zeha/wiener-netze-smartmeter-slop/site/og-image.png

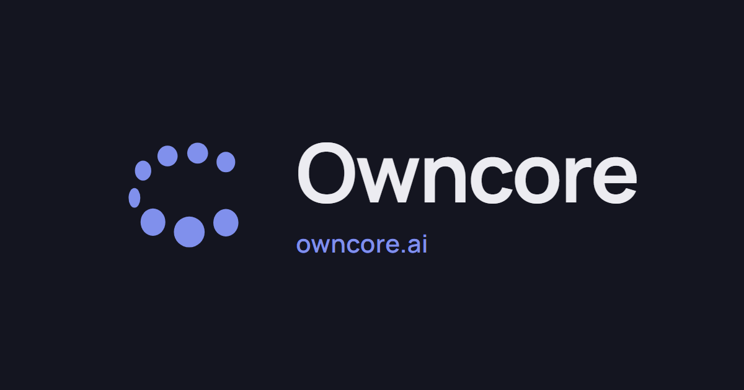
site/og-image.png
