zeha/wiener-netze-smartmeter-slop/hardware/power-dock/BOM.csv

Reference | Qty | Value | Package | LCSC | MPN | Manufacturer
U1 | 1 | TP4056 | ESOP-8 (SOIC-8 3.9x4.9 P1.27) | C725790 | TP4056 | UMW (Youtai)
U2 | 1 | AO3401 | SOT-23 (1=G 2=S 3=D) | C727156 | AO3401 | TWGMC
J1 | 1 | USB-C 16 pin | SMD USB-C (JLC footprint) | C393939 | TYPE-C16PIN | SHOU HAN
J2 | 1 | JST-PH 2P | JST-PH 2.0 mm, right-angle | C157932 | S2B-PH-K-S-GW | JST
J3 | 1 | JST-PH 2P (optional 2nd battery) | JST-PH 2.0 mm, right-angle | C157932 | S2B-PH-K-S-GW | JST
F1 | 1 | PTC 1A | 0805 | C22472456 | SMD0805-100C-6V | BNstar
F2 | 1 | PTC 1A (optional 2nd battery) | 0805 | C22472456 | SMD0805-100C-6V | BNstar
R1 | 1 | 5.1k | 0603 | C14677 | RC0603JR-075K1L | YAGEO
R7 | 1 | 5.1k | 0603 | C14677 | RC0603JR-075K1L | YAGEO
R2 | 1 | 2.4k | 0603 | C127450 | RC0603JR-072K4L | YAGEO
R3 | 1 | 1k | 0603 | C14676 | RC0603JR-071KL | YAGEO
R4 | 1 | 10k | 0603 | C99198 | RC0603JR-0710KL | YAGEO
R5 | 1 | 1M | 0603 | C107698 | RC0603JR-071ML | YAGEO
R6 | 1 | 1M | 0603 | C107698 | RC0603JR-071ML | YAGEO
C1 | 1 | 10uF 16V | 0603 | C108340 | 0603X106M160NT | FH
C2 | 1 | 10uF 16V | 0603 | C108340 | 0603X106M160NT | FH
D1 | 1 | red LED | 0603 | C19171390 | YLED0603R | YONGYUTAI
P1 | 1 | 1x6 header | 1x6 2.54 mm THT | C5156615 | 2.54-1*6 | ZHOURI
P2 | 1 | 1x4 header | 1x4 2.54 mm THT | C5116483 | 2.54-1*4 | ZHOURI
