zeha/wiener-netze-smartmeter-slop/hardware/power-dock/out/power-dock-schematic.pdf

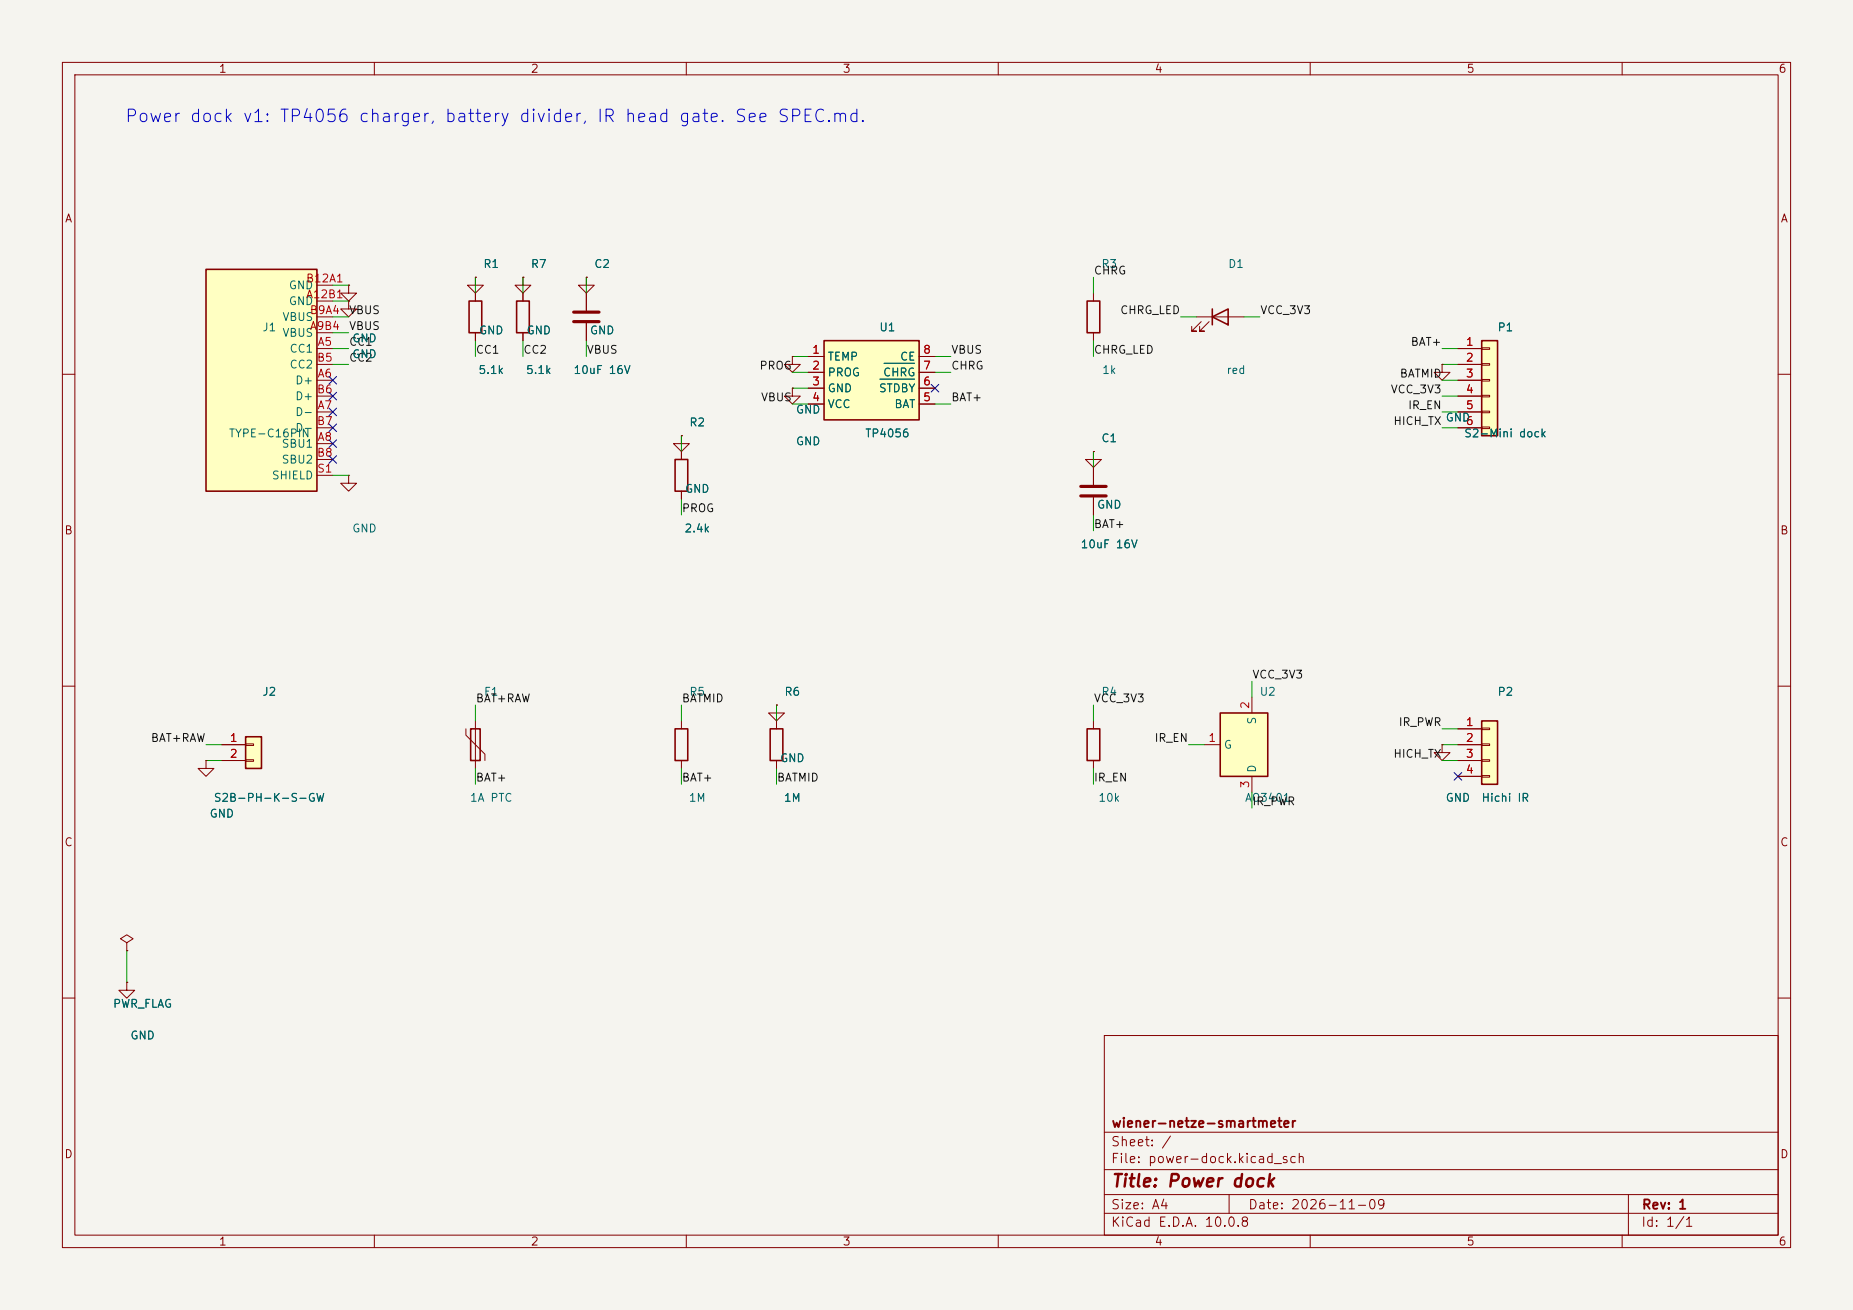
[picture p2: page 1]

Size: A4 | Rev: 1
KiCad E.D.A. 10.0.8 | Id: 1/1
