zeha/wiener-netze-smartmeter-slop/hardware/power-dock/out/power-dock-board.pdf

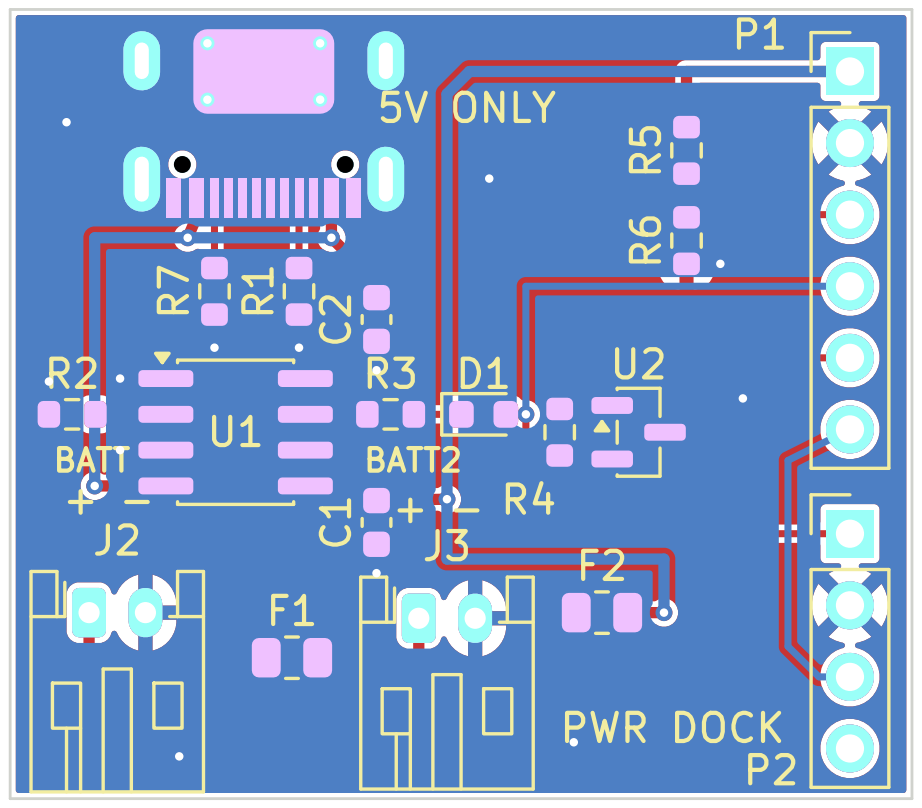
[picture p3: page 1]
