zeha/wiener-netze-smartmeter-slop/hardware/power-dock/power-dock.kicad_pcb

## KiCad design hardware/power-dock/power-dock.kicad_pcb (2026-11-11)

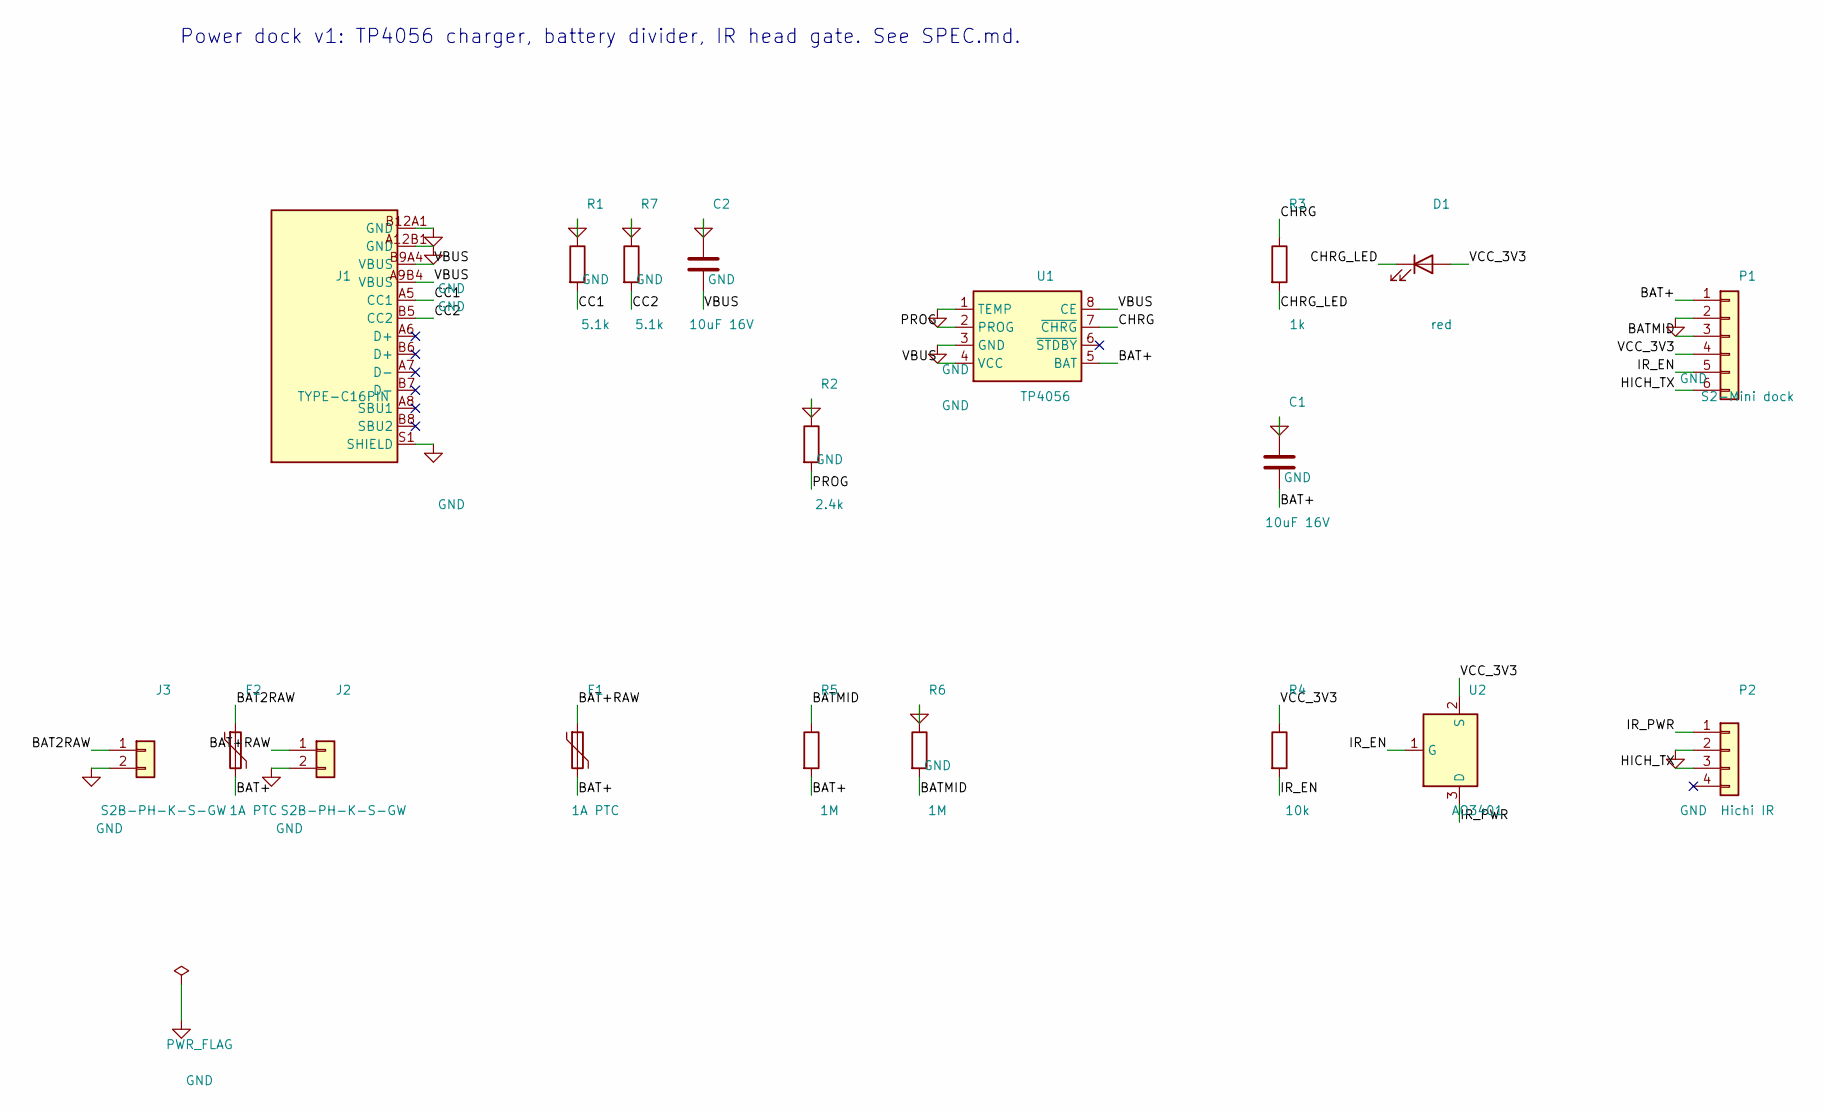
[picture p4: schematic power-dock.kicad_sch, Power dock]

Parts:
C1, C2: 10uF 16V; C_0603_1608Metric; MPN 0603X106M160NT; LCSC C108340
D1: red; LED_0603_1608Metric; MPN YLED0603R; LCSC C19171390
F1, F2: 1A PTC; R_0805_2012Metric; MPN SMD0805-100C-6V; LCSC C22472456
J1: TYPE-C16PIN; TYPE-C-SMD_HX-TYPE-C-16PIN; MPN TYPE-C16PIN; LCSC C393939
J2, J3: S2B-PH-K-S-GW; JST_PH_S2B-PH-K_1x02_P2.00mm_Horizontal; MPN S2B-PH-K-S-GW; LCSC C157932
P1: S2-Mini dock; PinHeader_1x06_P2.54mm_Vertical; MPN 2.54-1*6; LCSC C5156615
P2: Hichi IR; PinHeader_1x04_P2.54mm_Vertical; MPN 2.54-1*4; LCSC C5116483
R1, R7: 5.1k; R_0603_1608Metric; MPN RC0603JR-075K1L; LCSC C14677
R2: 2.4k; R_0603_1608Metric; MPN RC0603JR-072K4L; LCSC C127450
R3: 1k; R_0603_1608Metric; MPN RC0603JR-071KL; LCSC C14676
R4: 10k; R_0603_1608Metric; MPN RC0603JR-0710KL; LCSC C99198
R5, R6: 1M; R_0603_1608Metric; MPN RC0603JR-071ML; LCSC C107698
U1: TP4056; SOIC-8_3.9x4.9mm_P1.27mm; MPN TP4056; LCSC C725790
U2: AO3401; SOT-23; MPN AO3401; LCSC C727156

Connections:
/BAT2RAW: F2.1, J3.1
/BAT+: C1.2, F1.2, F2.2, P1.1, R5.2, U1.5 (BAT)
/BAT+RAW: F1.1, J2.1
/BATMID: P1.3, R5.1, R6.2
/CC1: J1.A5 (CC1), R1.2
/CC2: J1.B5 (CC2), R7.2
/CHRG: R3.1, U1.7 (~CHRG)
/CHRG_LED: D1.1 (K), R3.2
/HICH_TX: P1.6, P2.3
/IR_EN: P1.5, R4.2, U2.1 (G)
/IR_PWR: P2.1, U2.3 (D)
/PROG: R2.2, U1.2 (PROG)
/VBUS: C2.2, J1.A9B4 (VBUS), J1.B9A4 (VBUS), U1.4 (VCC), U1.8 (CE)
/VCC_3V3: D1.2 (A), P1.4, R4.1, U2.2 (S)
GND: C1.1, C2.1, J1.A12B1 (GND), J1.B12A1 (GND), J1.S1 (SHIELD), J2.2, J3.2, P1.2, P2.2, R1.1, R2.1, R6.1, R7.1, U1.1 (TEMP), U1.3 (GND)

Notes on the sheet:
Power dock v1: TP4056 charger, battery divider, IR head gate. See SPEC.md.

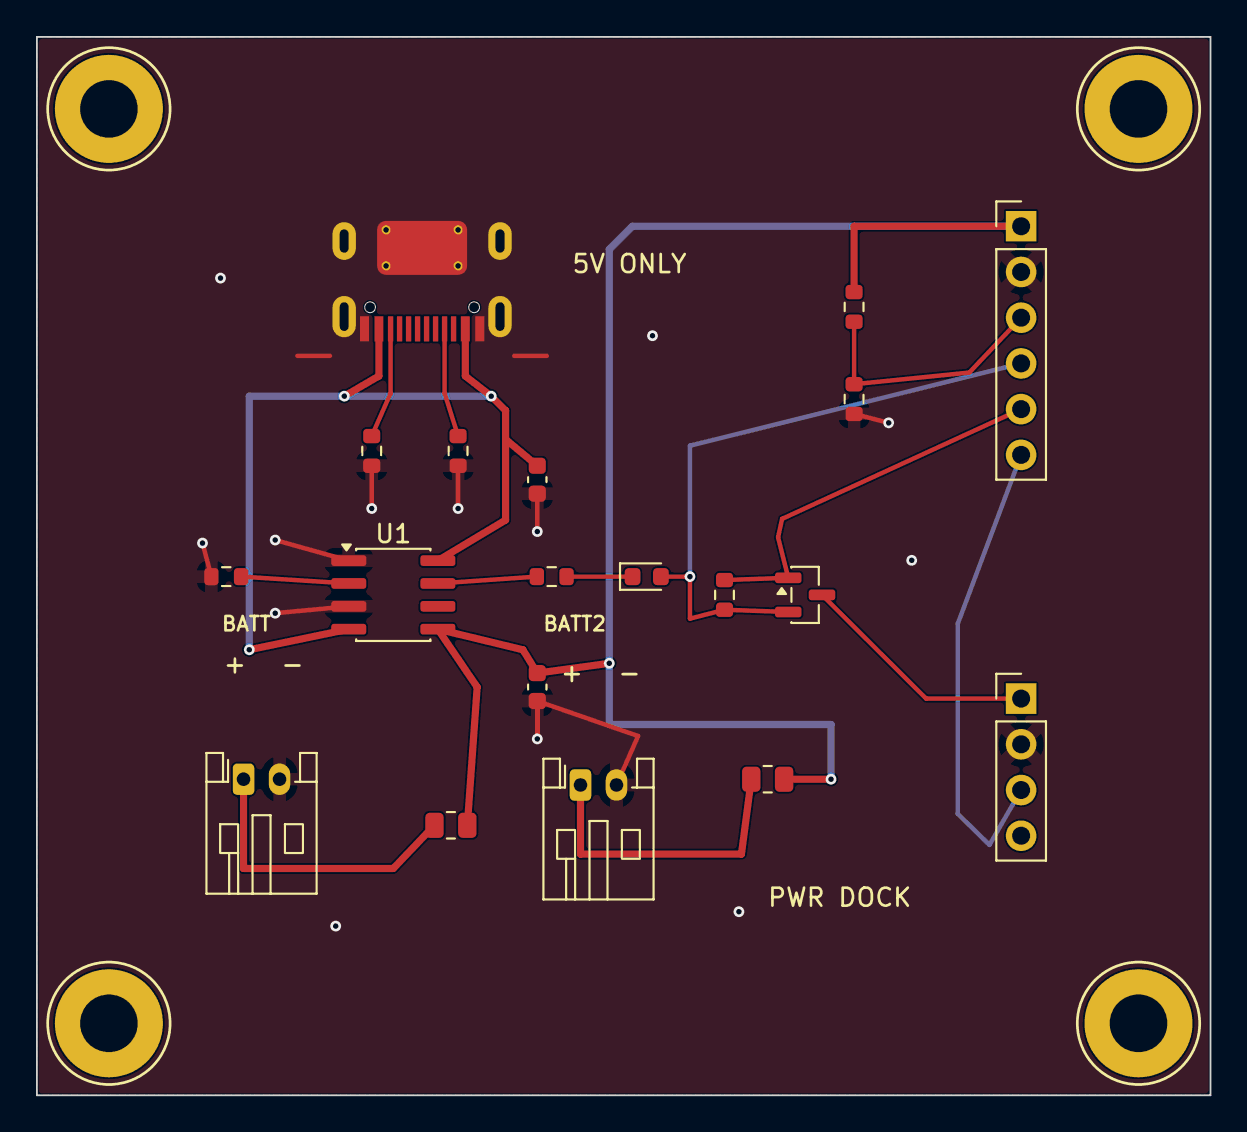
[picture p5: board power-dock.kicad_pcb from above]

Board: 2 copper layers, 65.2 x 58.8 mm, 23 parts (0 on the bottom side), 15 nets.

Other parts of the board:
MH1, MH2, MH3, MH4: 3.2mm; MountingHole_3.2mm_Pad
