zeha/wiener-netze-smartmeter-slop/(commit log)

2026-11-08 Add wiener_netze ESPHome component and example device config
2026-11-08 Drop deprecated UART settings check; the Python schema validates it
2026-11-08 Add battery voltage and level sensors to example config
2026-11-08 Fix battery wiring on overview page: LiPo to 5V/VBUS, not 3V3; note IR head idle current
2026-11-09 Add the required uart block to the install snippet on the overview page
    The snippet referenced uart_id meter_uart without defining the uart
    component, so ESPHome rejected it with 'Component wiener_netze requires
    component uart'. The snippet now includes the uart block (rx_pin GPIO21,
    9600 8N1) and says why it is mandatory; verified with esphome config.
2026-11-09 Fix the GitHub repo reference: it is wiener-netze-smartmeter-slop
    github.com/zeha/wiener-netze-smartmeter does not exist (404); the public
    repo is zeha/wiener-netze-smartmeter-slop, matching the git remote and the
    overview page. README snippet and the example config comment updated.
    [example_smartmeter.yaml]
2026-11-09 Name the actual hardware on the overview page: Hichi IR head, Olimex LiPo
    The wiring table now names the Hichi IR TTL v1.1 (TYP HB0014) read head
    (cable pointing downwards, cover the transmit LED in receive-only mode)
    and the Olimex BATTERY-LIPO7000mAh LiPo (2-pin JST-PH plug is not
    polarity-keyed: red = pin 1 = +). From the project's hardware research
    note; no secrets.
2026-11-09 power-dock: add design spec (BOM, nets, layout) for the TP4056 charging dock
2026-11-09 Add power dock KiCad project: generator, schematic, symbols and routed board
    [power-dock.kicad_pcb, power-dock.kicad_sch]
2026-11-09 Add power dock BOM, README, exports and netlist comparison script
    [BOM.csv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]
2026-11-10 power-dock: add polarity and 5V-only silkscreen labels; ignore KiCad reports
    - gr_text '+' / '-' under J2 (JST-PH) pins 1/2 (pin 1 = + = red wire,
    per Olimex USB-uLiPo BAT1 reference), 'BATT' label below
    - gr_text '5V ONLY' next to USB-C input (no overvoltage protection on
    VBUS -> TP4056)
    - DRC clean: 0 errors, 0 warnings
    - regenerate gerbers, board PDF/SVG, drill and pos files
    - gitignore *.rpt (DRC/ERC reports)
    [power-dock-B_Courtyard.gbr, power-dock-B_Cu.gbl, power-dock-B_Fab.gbr, power-dock-B_Mask.gbs, power-dock-B_Paste.gbp, power-dock-B_Silkscreen.gbo, power-dock-Edge_Cuts.gm1, power-dock-F_Courtyard.gbr]
2026-11-10 power-dock: add optional second battery (J3/F2, parallel, DNP-able)
    - J3: second JST-PH S2B-PH-K-S-GW socket next to J2 (silkscreen BATT2,
    +/ polarity marks), pin 1 = + like J2
    - F2: second 1 A PTC (SMD0805) on new net BAT2RAW between J3.1 and BAT+;
    0.4 mm F.Cu run + B.Cu return via (123.2, 121.4) to the BAT+ main via
    - optional: J3/F2 can be marked DNP (board then = single-battery dock)
    - J3 top silkscreen trimmed 0.3 mm to keep >= 0.2 mm board-edge clearance
    (one expected DRC warning: footprint differs from library copy)
    - PWR DOCK title moved right to clear J3 silkscreen
    - SPEC/README/BOM updated; ERC 0, DRC 0 errors, 0 unconnected pads;
    exports (gerbers, drill, pos, netlist, BOM,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
    [BOM.csv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]
2026-11-11 power-dock v2: 1.6x scale for rework access, mounting holes, JLC border clearance
    - Reproduce the v1 layout scaled 1.6x (47x40 -> 78x63 mm board) so
    connectors and components have enough room for manual rework
    - 4x mounting holes (3.2 mm) at the corners, 4 mm from the edges
    - 7 mm border margin all around for JLCPCB production
    - Route endpoints are anchored to their pads (1.0 mm tolerance,
    KiCad rotation convention), J1 exit tracks stay axis-aligned with
    the connector row; DRC: 0 violations, 0 unconnected items
    [power-dock.kicad_pcb]
2026-11-11 power-dock: regenerate production exports from the final v2 board
    Gerbers, drill, PnP, board PDF/SVG and copper-layer SVGs rebuilt from
    the DRC-clean 65.2 x 58.8 mm board (commit 8506c2d). Drops the stale
    v1 3D preview PNG (no headless 3D renderer available).
    [power-dock-B_Courtyard.gbr, power-dock-B_Cu.gbl, power-dock-B_Fab.gbr, power-dock-B_Mask.gbs, power-dock-B_Paste.gbp, power-dock-B_Silkscreen.gbo, power-dock-Edge_Cuts.gm1, power-dock-F_Courtyard.gbr]
2026-11-13 wiener_netze: build without sensor:/text_sensor: in the config
    The header included sensor.h and text_sensor.h unconditionally, but ESPHome
    only ships those components when the YAML loads them, so a config without a
    text_sensor: (or sensor:) block failed with 'sensor.h: No such file or
    directory'. Guard includes, members and publishes with USE_SENSOR /
    USE_TEXT_SENSOR and add two build regression configs.
2026-11-13 Read the IR head on GPIO11 with the internal pull-up; switch the dock's head supply on GPIO5
    Matches the existing Hichi IR TTL wiring (yellow data wire on GPIO11, pull-up
    enabled as in the old amsreader setup). ESPHome enables no pull-up on the UART
    RX pin by itself. Docs, test configs, power-dock jumper list and the site
    follow.
